rolandfiksdal/quadruped/stm32/quadruped_stm32/Core/Src/main.c

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
/* Includes ------------------------------------------------------------------*/
#include "main.h"

/* USER CODE BEGIN Includes */
#include "bmi088.h"
#include "robstride_can.h"
#include "robot_joints.h"
#include <stdio.h>

/* USER CODE END Includes */

/* USER CODE BEGIN PTD */

typedef enum
{
    POSE_DISABLED,
    POSE_STOPPING,
    POSE_TRANSITIONING,
    POSE_HOLDING
} PoseState_t;

/* Which pose is selected is separate from whether it is moving or holding. */
typedef enum
{
    TARGET_RETRACTED,
    TARGET_STANDING,
    TARGET_RETRACTED_BEFORE_REST,
    TARGET_RESTING
} PoseTarget_t;

typedef struct
{
    MotorId_t joint;
    const char *name;
    float target_rad;
} JointTarget_t;

/* USER CODE END PTD */

/* USER CODE BEGIN PD */
#define COMMAND_INTERVAL_MS 20U
#define COMMAND_BATCH_TIMEOUT_MS 50U

/* USER CODE END PD */


COM_InitTypeDef BspCOMInit;
FDCAN_HandleTypeDef hfdcan1;

SPI_HandleTypeDef hspi3;

/* USER CODE BEGIN PV */
static const JointTarget_t standing_targets[] =
    {
        {MOTOR_FL_HAA, "FL_HAA", 0.0f},
        {MOTOR_FL_HFE, "FL_HFE", -0.7f},
        {MOTOR_FL_KFE, "FL_KFE", 1.2f},
        {MOTOR_FR_HAA, "FR_HAA", 0.0f},
        {MOTOR_FR_HFE, "FR_HFE", -0.7f},
        {MOTOR_FR_KFE, "FR_KFE", 1.2f},
        {MOTOR_RL_HAA, "RL_HAA", 0.0f},
        {MOTOR_RL_HFE, "RL_HFE", -0.7f},
        {MOTOR_RL_KFE, "RL_KFE", 1.2f},
        {MOTOR_RR_HAA, "RR_HAA", 0.0f},
        {MOTOR_RR_HFE, "RR_HFE", -0.7f},
        {MOTOR_RR_KFE, "RR_KFE", 1.2f}};

static const JointTarget_t retracted_targets[] =
    {
        {MOTOR_FL_HAA, "FL_HAA", 0.0f},
        {MOTOR_FL_HFE, "FL_HFE", -0.852f},
        {MOTOR_FL_KFE, "FL_KFE", 2.34f},
        {MOTOR_FR_HAA, "FR_HAA", 0.0f},
        {MOTOR_FR_HFE, "FR_HFE", -0.853f},
        {MOTOR_FR_KFE, "FR_KFE", 2.34f},
        {MOTOR_RL_HAA, "RL_HAA", 0.0f},
        {MOTOR_RL_HFE, "RL_HFE", -0.877f},
        {MOTOR_RL_KFE, "RL_KFE", 2.34f},
        {MOTOR_RR_HAA, "RR_HAA", 0.0f},
        {MOTOR_RR_HFE, "RR_HFE", -0.857f},
        {MOTOR_RR_KFE, "RR_KFE", 2.34f}};

static const JointTarget_t resting_targets[] =
    {
        {MOTOR_FL_HAA, "FL_HAA", -0.47f},
        {MOTOR_FL_HFE, "FL_HFE", -0.852f},
        {MOTOR_FL_KFE, "FL_KFE", 2.34f},
        {MOTOR_FR_HAA, "FR_HAA", -0.47f},
        {MOTOR_FR_HFE, "FR_HFE", -0.853f},
        {MOTOR_FR_KFE, "FR_KFE", 2.34f},
        {MOTOR_RL_HAA, "RL_HAA", -0.47f},
        {MOTOR_RL_HFE, "RL_HFE", -0.877f},
        {MOTOR_RL_KFE, "RL_KFE", 2.34f},
        {MOTOR_RR_HAA, "RR_HAA", -0.47f},
        {MOTOR_RR_HFE, "RR_HFE", -0.857f},
        {MOTOR_RR_KFE, "RR_KFE", 2.34f}};

#define POSE_JOINT_COUNT (sizeof(standing_targets) / sizeof(standing_targets[0]))

_Static_assert(POSE_JOINT_COUNT == ROBSTRIDE_MOTOR_COUNT, "Pose must cover all motors");
_Static_assert(sizeof(retracted_targets) == sizeof(standing_targets), "Pose sizes must match");
_Static_assert(sizeof(resting_targets) == sizeof(standing_targets), "Pose sizes must match");

static const JointTarget_t *active_targets = retracted_targets;
static PoseTarget_t selected_pose = TARGET_RETRACTED;
static const char *active_pose_name = "retracted";

float start_positions_rad[POSE_JOINT_COUNT];
uint32_t transition_start_ms;
uint32_t last_command_ms;
uint32_t last_batch_duration_ms = 0;
uint32_t max_batch_duration_ms = 0;
uint8_t next_joint_index = 0;
uint8_t batch_in_progress = 0;
uint32_t batch_start_ms;
float batch_progress = 0.0f;
uint32_t last_batch_gap_ms = 0;
uint32_t max_batch_gap_ms = 0;
uint8_t have_previous_batch = 0;
/* Powered actuators may still be active after an MCU-only reset. */
PoseState_t pose_state = POSE_STOPPING;

volatile uint8_t acc_data_ready = 0;
volatile uint8_t gyro_data_ready = 0;
volatile uint8_t user_button_pressed = 0;
volatile uint32_t last_button_irq = 0;

volatile uint32_t acc_irq_count = 0;
volatile uint32_t gyro_irq_count = 0;
/* USER CODE END PV */

void SystemClock_Config(void);
static void MX_GPIO_Init(void);
static void MX_FDCAN1_Init(void);
static void MX_SPI3_Init(void);
/* USER CODE BEGIN 0 */
static const char *JointHealthReason(JointResult_t result)
{
    switch (result)
    {
        case JOINT_OK: return "healthy";
        case JOINT_INVALID_ID: return "invalid joint ID";
        case JOINT_OFFLINE: return "offline or state unavailable";
        case JOINT_FAULT: return "motor fault reported";
        case JOINT_NO_FEEDBACK: return "no measurement feedback received";
        case JOINT_STALE_FEEDBACK: return "measurement feedback stale";
        default: return "unexpected joint result";
    }
}

/* Supported-test policy: cancel motion and request all motors stop.
 * Disabling removes support; this is not a controlled ground-standing recovery.
 */
static void MonitorPoseHealth(void)
{
    if (pose_state != POSE_TRANSITIONING && pose_state != POSE_HOLDING)
    {
        return;
    }

    for (uint8_t i = 0; i < POSE_JOINT_COUNT; i++)
    {
        JointResult_t health = RobotJoints_CheckHealth(active_targets[i].joint);
        if (health != JOINT_OK)
        {
            batch_in_progress = 0;
            pose_state = POSE_STOPPING;
            user_button_pressed = 0;
            /* Report once: subsequent checks skip POSE_STOPPING. */
            printf("%s unhealthy: %s; requesting all motors stop\r\n",
                   active_targets[i].name, JointHealthReason(health));
            return;
        }
    }
}

/* Return true only when every stop request was queued successfully. */
static uint8_t StopAllJoints(void)
{
    uint8_t all_stopped = 1;

    for (uint8_t i = 0; i < POSE_JOINT_COUNT; i++)
    {
        JointResult_t result = RobotJoints_Stop(active_targets[i].joint);
        if (result != JOINT_OK)
        {
            printf("%s stop failed: %d\r\n", active_targets[i].name, result);
            all_stopped = 0;
        }
        HAL_Delay(2);
        RobStride_CAN_Process();
    }

    batch_in_progress = 0;
    if (all_stopped)
    {
        /* Discard presses received while stop requests were being submitted. */
        user_button_pressed = 0;
        pose_state = POSE_DISABLED;
        selected_pose = TARGET_RETRACTED;
        active_targets = retracted_targets;
        active_pose_name = "retracted";
    }

    return all_stopped;
}


/* Validate the whole destination and capture measured starts before moving. */
static void StartPoseTransition(PoseTarget_t requested_pose)
{
    if (pose_state != POSE_DISABLED && pose_state != POSE_HOLDING)
    {
        return;
    }

    const JointTarget_t *targets;
    const char *name;

    switch (requested_pose)
    {
        case TARGET_RETRACTED:
            targets = retracted_targets;
            name = "retracted";
            break;
        case TARGET_STANDING:
            targets = standing_targets;
            name = "standing";
            break;
        case TARGET_RETRACTED_BEFORE_REST:
            targets = retracted_targets;
            name = "retracted before resting";
            break;
        case TARGET_RESTING:
            targets = resting_targets;
            name = "resting";
            break;
        default:
            return;
    }

    uint8_t targets_valid = 1;
    for (uint8_t i = 0; i < POSE_JOINT_COUNT; i++)
    {
        if (RobotJoints_ValidatePosition(targets[i].joint,
                                        targets[i].target_rad) != JOINT_OK)
        {
            printf("%s rejected: %s target=%+.5f rad outside command limits\r\n",
                   name, targets[i].name, targets[i].target_rad);
            targets_valid = 0;
        }
    }
    if (!targets_valid)
    {
        return;
    }

    RobStride_CAN_Process();
    RobStride_UpdateOnlineStatus();
    uint8_t ready = 1;
    for (uint8_t i = 0; i < POSE_JOINT_COUNT; i++)
    {
        JointState_t state;
        JointResult_t health = RobotJoints_CheckHealth(targets[i].joint);
        if (health != JOINT_OK)
        {
            printf("%s not ready: %s\r\n",
                   targets[i].name, JointHealthReason(health));
            ready = 0;
        }
        else if (!RobotJoints_GetState(targets[i].joint, &state))
        {
            printf("%s not ready: state unavailable\r\n", targets[i].name);
            ready = 0;
        }
        else if (!RobotJoints_PrepareStartPosition(targets[i].joint,
                                                  state.position_rad,
                                                  &start_positions_rad[i]))
        {
            printf("%s starting position rejected: %+.5f rad\r\n",
                   targets[i].name, state.position_rad);
            ready = 0;
        }
    }
    if (!ready)
    {
        if (pose_state != POSE_DISABLED)
        {
            batch_in_progress = 0;
            pose_state = POSE_STOPPING;
        }
        return;
    }

    /* Motors stay enabled between poses; only the first press enables them. */
    if (pose_state == POSE_DISABLED)
    {
        for (uint8_t i = 0; i < POSE_JOINT_COUNT; i++)
        {
            JointResult_t result = RobotJoints_Enable(targets[i].joint);
            if (result != JOINT_OK)
            {
                printf("%s enable failed: %d\r\n", targets[i].name, result);
                batch_in_progress = 0;
                pose_state = POSE_STOPPING;
                return;
            }
            HAL_Delay(2);
            RobStride_CAN_Process();
        }
    }

    active_targets = targets;
    selected_pose = requested_pose;
    active_pose_name = name;
    next_joint_index = 0;
    batch_in_progress = 0;
    batch_progress = 0.0f;
    have_previous_batch = 0;
    last_batch_gap_ms = 0;
    max_batch_gap_ms = 0;
    last_batch_duration_ms = 0;
    max_batch_duration_ms = 0;

    printf("Moving to %s over 2 seconds\r\n", name);
    transition_start_ms = HAL_GetTick();
    last_command_ms = transition_start_ms - COMMAND_INTERVAL_MS;
    pose_state = POSE_TRANSITIONING;
}

/* USER CODE END 0 */

/**
 * @brief  The application entry point.
 * @retval int
 */
int main(void)
{

    /* MCU Configuration--------------------------------------------------------*/

    /* Reset of all peripherals, Initializes the Flash interface and the Systick. */
    HAL_Init();

    /* Configure the system clock */
    SystemClock_Config();

    /* Initialize all configured peripherals */
    MX_GPIO_Init();
    MX_FDCAN1_Init();
    MX_SPI3_Init();
    /* Initialize led */
    BSP_LED_Init(LED_GREEN);

    /* Initialize USER push-button, will be used to trigger an interrupt each time it's pressed.*/
    BSP_PB_Init(BUTTON_USER, BUTTON_MODE_EXTI);

    /* Initialize COM1 port (115200, 8 bits (7-bit data + 1 stop bit), no parity */
    BspCOMInit.BaudRate = 115200;
    BspCOMInit.WordLength = COM_WORDLENGTH_8B;
    BspCOMInit.StopBits = COM_STOPBITS_1;
    BspCOMInit.Parity = COM_PARITY_NONE;
    BspCOMInit.HwFlowCtl = COM_HWCONTROL_NONE;
    if (BSP_COM_Init(COM1, &BspCOMInit) != BSP_ERROR_NONE)
    {
        Error_Handler();
    }

    /* Infinite loop */
    /* USER CODE BEGIN WHILE */

    RobotJoints_Init();

    if (!RobStride_CAN_Init())
    {
        printf("CAN init failed; startup blocked, motor stops not confirmed\r\n");
        Error_Handler();
    }
    else
    {
        printf("CAN init success\r\n");

        /* Stop before discovery, reporting setup, or IMU initialization.
         * RobotJoints_Stop does not require a motor to be discovered/online.
         * Stay here on submission failure; pose/button handling cannot run.
         */
        while (!StopAllJoints())
        {
            user_button_pressed = 0;
        }
        printf("Startup: all 12 stop requests queued; motor disable unconfirmed\r\n");

        RobStride_RequestAllDeviceIDs();

        HAL_Delay(200);

        /*
         * responses are sitting in FIFO0,
         * so process them before inspecting states.
         */
        RobStride_CAN_Process();

        RobStride_SetAllActiveReporting(1);

        uint8_t online_count = 0;

        for (uint8_t id = 1; id <= ROBSTRIDE_MOTOR_COUNT; id++)
        {
            const RobStride_Motor_t *motor =
                RobStride_GetMotor((MotorId_t)id);

            if (motor != NULL && motor->online)
            {
                printf("Motor %2u: ONLINE\r\n", id);
                online_count++;
            }
            else
            {
                printf("Motor %2u: OFFLINE\r\n", id);
            }
        }

        printf("%u/%u motors online\r\n",
               online_count,
               ROBSTRIDE_MOTOR_COUNT);
    }

    if (!BMI088_Init())
    {
        printf("BMI088 init failed\r\n");
    }
    else
    {
        printf("BMI088 init success\r\n");
    }

    printf("Feedback timeout: %lu ms (provisional supported-test limit)\r\n",
           (unsigned long)ROBOT_FEEDBACK_TIMEOUT_MS);
    printf("Startup complete; press button to begin\r\n");
    /* Also discard presses during discovery, IMU init, and startup logging. */
    user_button_pressed = 0;

    uint32_t last_joint_print = 0;

    while (1)
    {
        RobStride_CAN_Process();

        RobStride_UpdateOnlineStatus();

        MonitorPoseHealth();

        if ((pose_state == POSE_DISABLED || pose_state == POSE_HOLDING) &&
            HAL_GetTick() - last_joint_print >= 800)
        {
            last_joint_print = HAL_GetTick();
            printf("Pose: %s, %s\r\n", active_pose_name,
                   pose_state == POSE_DISABLED ? "DISABLED (next target)" : "HOLDING");

            for (uint8_t id = 1; id <= ROBSTRIDE_MOTOR_COUNT; id++)
            {
                JointState_t state;

                if (RobotJoints_GetState((MotorId_t)id, &state))
                {
                    printf(
                        "Motor %2u: joint=%+.4f rad, torque=%+.3f Nm, temp=%.1f C, %s",
                        id,
                        state.position_rad,
                        state.torque_nm,
                        state.temperature_c,
                        state.online ? "ONLINE" : "OFFLINE");
                    if (state.feedback_received)
                    {
                        printf(", feedback age=%lu ms, gap last/max=%lu/%lu ms%s",
                               (unsigned long)state.feedback_age_ms,
                               (unsigned long)state.feedback_gap_last_ms,
                               (unsigned long)state.feedback_gap_max_ms,
                               state.feedback_age_ms >= ROBOT_FEEDBACK_TIMEOUT_MS
                                   ? " STALE" : "");
                    }
                    else
                    {
                        printf(", NO MEASUREMENT FEEDBACK");
                    }
                    for (uint8_t i = 0; i < POSE_JOINT_COUNT; i++)
                    {
                        if ((MotorId_t)id == active_targets[i].joint)
                        {
                            /* Signed remaining angle: target minus feedback. */
                            printf(
                                ", %s target=%+.4f rad, error=%+.4f rad",
                                active_targets[i].name,
                                active_targets[i].target_rad,
                                active_targets[i].target_rad - state.position_rad);
                            break;
                        }
                    }
                    printf("\r\n");
                }
                else
                {
                    printf("Motor %2u: state unavailable\r\n", id);
                }
                /* Service feedback between the blocking serial output lines. */
                RobStride_CAN_Process();
                RobStride_UpdateOnlineStatus();
                MonitorPoseHealth();
                if (pose_state == POSE_STOPPING)
                {
                    break;
                }
            }
            if (pose_state != POSE_STOPPING)
            {
                printf(
                    "Batch duration: last=%lu max=%lu ms; "
                    "start gap: last=%lu max=%lu ms\r\n",
                    (unsigned long)last_batch_duration_ms,
                    (unsigned long)max_batch_duration_ms,
                    (unsigned long)last_batch_gap_ms,
                    (unsigned long)max_batch_gap_ms
                );
            }
        }

        if (user_button_pressed)
        {
            user_button_pressed = 0;

            if (pose_state == POSE_TRANSITIONING)
            {
                printf("Still moving to %s; press again after the ramp finishes\r\n",
                       active_pose_name);
            }
            else if (pose_state == POSE_STOPPING)
            {
                /* The stop handler below retries all stop requests. */
            }
            else if (pose_state == POSE_DISABLED)
            {
                StartPoseTransition(TARGET_RETRACTED);
            }
            else if (selected_pose == TARGET_RETRACTED)
            {
                StartPoseTransition(TARGET_STANDING);
            }
            else if (selected_pose == TARGET_STANDING)
            {
                StartPoseTransition(TARGET_RETRACTED_BEFORE_REST);
            }
            else if (selected_pose == TARGET_RETRACTED_BEFORE_REST)
            {
                StartPoseTransition(TARGET_RESTING);
            }
            else
            {
                batch_in_progress = 0;
                pose_state = POSE_STOPPING;
            }
        }
        /* Starting a pose can process new feedback while enabling motors.
         * Recheck it before submitting any position command.
         */
        RobStride_CAN_Process();
        RobStride_UpdateOnlineStatus();
        MonitorPoseHealth();

        if (pose_state == POSE_TRANSITIONING)
        {
            uint32_t now = HAL_GetTick();

            /* Start a new batch only when the previous one is finished and time is due. */
            if (!batch_in_progress &&
                now - last_command_ms >= COMMAND_INTERVAL_MS)
            {
                if (have_previous_batch)
                {
                    last_batch_gap_ms = now - last_command_ms;

                    if (last_batch_gap_ms > max_batch_gap_ms)
                    {
                        max_batch_gap_ms = last_batch_gap_ms;
                    }
                }

                have_previous_batch = 1;

                next_joint_index = 0;
                batch_start_ms = now;
                last_command_ms = now;

                uint32_t elapsed_ms = now - transition_start_ms;
                batch_progress = (float)elapsed_ms / 2000.0f;

                if (batch_progress > 1.0f)
                {
                    batch_progress = 1.0f;
                }

                batch_in_progress = 1;
            }

            if (batch_in_progress &&
                now - batch_start_ms >= COMMAND_BATCH_TIMEOUT_MS)
            {
                batch_in_progress = 0;
                pose_state = POSE_STOPPING;

                printf("Batch timeout: queued %u/%u commands\r\n",
                    (unsigned int)next_joint_index,
                    (unsigned int)POSE_JOINT_COUNT);
            }

            /* Attempt at most one command per main-loop pass. */
            if (batch_in_progress && RobStride_CAN_CanSend())
            {
                uint8_t i = next_joint_index;

                float s = batch_progress;
                float smooth_progress = s * s * (3.0f - 2.0f * s);

                float target =
                    start_positions_rad[i]
                    + (active_targets[i].target_rad - start_positions_rad[i])
                    * smooth_progress;

                JointResult_t result = RobotJoints_Command(
                    active_targets[i].joint,
                    target,
                    0.0f,
                    0.0f,
                    60.0f,
                    5.0f);

                if (result != JOINT_OK)
                {
                    printf("%s command failed: %d\r\n",
                        active_targets[i].name, result);

                    batch_in_progress = 0;
                    pose_state = POSE_STOPPING;
                }
                else
                {
                    next_joint_index++;

                    if (next_joint_index == POSE_JOINT_COUNT)
                    {
                        batch_in_progress = 0;

                        last_batch_duration_ms =
                            HAL_GetTick() - batch_start_ms;

                        if (last_batch_duration_ms > max_batch_duration_ms)
                        {
                            max_batch_duration_ms = last_batch_duration_ms;
                        }

                        if (batch_progress >= 1.0f)
                        {
                            pose_state = POSE_HOLDING;
                            printf("%s ramp finished; final targets queued\r\n",
                                   active_pose_name);
                        }
                    }
                }
            }
        }

        if (pose_state == POSE_STOPPING)
        {
            if (StopAllJoints())
            {
                printf("All 12 joint stop requests queued\r\n");
            }
        }
    }
    /* USER CODE END WHILE */

}

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
/* USER CODE BEGIN 4 */

void HAL_GPIO_EXTI_Callback(uint16_t GPIO_Pin)
{
    if (GPIO_Pin == ACC_INT_Pin)
    {
        acc_data_ready = 1;
        acc_irq_count++;
    }

    if (GPIO_Pin == GYRO_INT_Pin)
    {
        gyro_data_ready = 1;
        gyro_irq_count++;
    }

    if (GPIO_Pin == B1_BUTTON_Pin)
    {
        uint32_t now = HAL_GetTick();

        if (now - last_button_irq > 50)
        {
            last_button_irq = now;
            user_button_pressed = 1;
        }
    }
}

/* USER CODE END 4 */
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
