rolandfiksdal/quadruped/stm32/quadruped_stm32/Core/Inc/main.h

#define B1_BUTTON_Pin GPIO_PIN_13
#define B1_BUTTON_GPIO_Port GPIOC
#define B1_BUTTON_EXTI_IRQn EXTI15_10_IRQn
#define RCC_OSC32_IN_Pin GPIO_PIN_14
#define RCC_OSC32_IN_GPIO_Port GPIOC
#define RCC_OSC32_OUT_Pin GPIO_PIN_15
#define RCC_OSC32_OUT_GPIO_Port GPIOC
#define RCC_OSC_IN_Pin GPIO_PIN_0
#define RCC_OSC_IN_GPIO_Port GPIOF
#define RCC_OSC_OUT_Pin GPIO_PIN_1
#define RCC_OSC_OUT_GPIO_Port GPIOF
#define ACC_INT_Pin GPIO_PIN_4
#define ACC_INT_GPIO_Port GPIOC
#define ACC_INT_EXTI_IRQn EXTI4_IRQn
#define GYRO_INT_Pin GPIO_PIN_5
#define GYRO_INT_GPIO_Port GPIOC
#define GYRO_INT_EXTI_IRQn EXTI9_5_IRQn
#define T_SWDIO_Pin GPIO_PIN_13
#define T_SWDIO_GPIO_Port GPIOA
#define T_SWCLK_Pin GPIO_PIN_14
#define T_SWCLK_GPIO_Port GPIOA
#define T_SWO_Pin GPIO_PIN_3
#define T_SWO_GPIO_Port GPIOB
#define ACC_CS_Pin GPIO_PIN_6
#define ACC_CS_GPIO_Port GPIOB
#define GYRO_CS_Pin GPIO_PIN_7
#define GYRO_CS_GPIO_Port GPIOB
