rolandfiksdal/quadruped/stm32/quadruped_stm32/Core/Src/robot_joints.c

#include "robot_joints.h"
#include <stddef.h>
#include <math.h>

/* Constants */

#define DEG_TO_RAD 0.01745329252f
#define PI_F       3.14159265f
#define TWO_PI_F   6.28318531f
#define START_POSITION_TOLERANCE_RAD 0.008f

/* Private calibration data; array index is the motor/joint ID. */

typedef struct
{
    int8_t sign;

    float motor_reference_rad;
    float joint_reference_rad;

    float min_rad;
    float max_rad;

} JointConfig_t;

/* IDs start at 1; index 0 is unused. */
static JointConfig_t joint_config[ROBSTRIDE_MOTOR_COUNT + 1];

/* Private coordinate helpers */

static uint8_t RobotJoints_IsValid(MotorId_t joint)
{
    return joint >= 1 &&
           joint <= ROBSTRIDE_MOTOR_COUNT;
}

static float RobotJoints_WrapToPi(float angle)
{
    while (angle > PI_F)
    {
        angle -= TWO_PI_F;
    }

    while (angle < -PI_F)
    {
        angle += TWO_PI_F;
    }

    return angle;
}

static float RobotJoints_JointToMotorPosition(
    MotorId_t joint,
    float joint_position_rad)
{
    const JointConfig_t *config =
        &joint_config[joint];

    const RobStride_Motor_t *motor =
        RobStride_GetMotor(joint);

    float base_target =
        config->motor_reference_rad
        + config->sign *
          (joint_position_rad -
           config->joint_reference_rad);

    if (motor == NULL)
    {
        return base_target;
    }

    /*
     * Move the target onto the 2*pi-equivalent branch
     * closest to the motor's current reported position.
     */
    while (base_target - motor->position_rad > PI_F)
    {
        base_target -= TWO_PI_F;
    }

    while (base_target - motor->position_rad < -PI_F)
    {
        base_target += TWO_PI_F;
    }

    return base_target;
}

/* Initialization / calibration */

void RobotJoints_Init(void)
{
    /*
     * FL HAA
     * Motor zero = minimum abduction position.
     * Negative motor rotation = positive joint abduction.
     */
    joint_config[MOTOR_FL_HAA] = (JointConfig_t)
    {
        .sign = -1,
        .motor_reference_rad = 0.0f,
        .joint_reference_rad = -27.5f * DEG_TO_RAD,
        .min_rad = -27.5f * DEG_TO_RAD,
        .max_rad =  27.5f * DEG_TO_RAD
    };

    /*
     * FR HAA
     * Positive motor rotation = positive joint abduction.
     */
    joint_config[MOTOR_FR_HAA] = (JointConfig_t)
    {
        .sign = +1,
        .motor_reference_rad = 0.0f,
        .joint_reference_rad = -27.5f * DEG_TO_RAD,
        .min_rad = -27.5f * DEG_TO_RAD,
        .max_rad =  27.5f * DEG_TO_RAD
    };

    /*
     * RL HAA
     */
    joint_config[MOTOR_RL_HAA] = (JointConfig_t)
    {
        .sign = +1,
        .motor_reference_rad = 0.0f,
        .joint_reference_rad = -27.5f * DEG_TO_RAD,
        .min_rad = -27.5f * DEG_TO_RAD,
        .max_rad =  27.5f * DEG_TO_RAD
    };

    /*
     * RR HAA
     */
    joint_config[MOTOR_RR_HAA] = (JointConfig_t)
    {
        .sign = -1,
        .motor_reference_rad = 0.0f,
        .joint_reference_rad = -27.5f * DEG_TO_RAD,
        .min_rad = -27.5f * DEG_TO_RAD,
        .max_rad =  27.5f * DEG_TO_RAD
    };

    joint_config[MOTOR_FL_HFE] = (JointConfig_t)
    {
        .sign = +1,
        .motor_reference_rad = 6.590f,
        .joint_reference_rad = 0.0f,
        .min_rad = -1.360f,
        .max_rad = +0.620f
    };

    joint_config[MOTOR_FR_HFE] = (JointConfig_t)
    {
        .sign = -1,
        .motor_reference_rad = 5.368f,
        .joint_reference_rad = 0.0f,
        .min_rad = -1.360f,
        .max_rad = +0.620f
    };

    joint_config[MOTOR_RL_HFE] = (JointConfig_t)
    {
        .sign = +1,
        .motor_reference_rad = 3.520f,
        .joint_reference_rad = 0.0f,
        .min_rad = -1.360f,
        .max_rad = +0.620f
    };

    joint_config[MOTOR_RR_HFE] = (JointConfig_t)
    {
        .sign = -1,
        .motor_reference_rad = 5.238f,
        .joint_reference_rad = 0.0f,
        .min_rad = -1.360f,
        .max_rad = +0.620f
    };

    joint_config[MOTOR_FL_KFE] = (JointConfig_t)
    {
        .sign = +1,

        .motor_reference_rad = -0.211053f,
        .joint_reference_rad = 134.82f * DEG_TO_RAD,

        .min_rad = 0.8379f,
        .max_rad = 2.353f
    };

    joint_config[MOTOR_FR_KFE] = (JointConfig_t)
    {
        .sign = -1,

        .motor_reference_rad = +0.204553f,
        .joint_reference_rad = 134.82f * DEG_TO_RAD,

        .min_rad = 0.8562f,
        .max_rad = 2.353f
    };

    joint_config[MOTOR_RL_KFE] = (JointConfig_t)
    {
        .sign = +1,

        .motor_reference_rad = +3.978647f,
        .joint_reference_rad = 134.82f * DEG_TO_RAD,

        .min_rad = 0.8535f,
        .max_rad = 2.353f
    };

    joint_config[MOTOR_RR_KFE] = (JointConfig_t)
    {
        .sign = -1,

        .motor_reference_rad = +5.516853f,
        .joint_reference_rad = 134.82f * DEG_TO_RAD,

        .min_rad = 0.8309f,
        .max_rad = 2.353f
    };
}

/* Joint state / target inspection */

JointResult_t RobotJoints_CheckHealth(MotorId_t joint)
{
    if (!RobotJoints_IsValid(joint))
    {
        return JOINT_INVALID_ID;
    }

    const RobStride_Motor_t *motor = RobStride_GetMotor(joint);
    if (motor == NULL || !motor->online)
    {
        return JOINT_OFFLINE;
    }

    if (motor->fault_bits != 0)
    {
        return JOINT_FAULT;
    }

    if (!motor->feedback_received)
    {
        return JOINT_NO_FEEDBACK;
    }

    /* Unsigned subtraction also handles the HAL tick counter wrapping. */
    if ((uint32_t)(HAL_GetTick() - motor->last_feedback_ms) >=
        ROBOT_FEEDBACK_TIMEOUT_MS)
    {
        return JOINT_STALE_FEEDBACK;
    }

    return JOINT_OK;
}

uint8_t RobotJoints_GetState(
    MotorId_t joint,
    JointState_t *state)
{
    if (!RobotJoints_IsValid(joint) || state == NULL)
    {
        return 0;
    }

    const RobStride_Motor_t *motor =
        RobStride_GetMotor(joint);

    if (motor == NULL)
    {
        return 0;
    }

    const JointConfig_t *config =
        &joint_config[joint];

    float motor_delta =
        RobotJoints_WrapToPi(
            motor->position_rad -
            config->motor_reference_rad
        );

    state->position_rad =
        config->sign * motor_delta
        + config->joint_reference_rad;

    state->velocity_rad_s =
        config->sign *
        motor->velocity_rad_s;

    state->torque_nm =
        config->sign *
        motor->torque_nm;

    state->temperature_c =
        motor->temperature_c;

    state->online =
        motor->online;

    state->fault_bits =
        motor->fault_bits;

    state->feedback_received = motor->feedback_received;
    state->feedback_age_ms = motor->feedback_received
        ? (uint32_t)(HAL_GetTick() - motor->last_feedback_ms) : 0;
    state->feedback_gap_last_ms = motor->feedback_gap_last_ms;
    state->feedback_gap_max_ms = motor->feedback_gap_max_ms;

    return 1;
}

float RobotJoints_GetMotorTarget(
    MotorId_t joint,
    float joint_position_rad)
{
    if (!RobotJoints_IsValid(joint))
    {
        return 0.0f;
    }

    return RobotJoints_JointToMotorPosition(
        joint,
        joint_position_rad);
}

uint8_t RobotJoints_PrepareStartPosition(
    MotorId_t joint,
    float measured_position_rad,
    float *start_position_rad)
{
    if (!RobotJoints_IsValid(joint) ||
        start_position_rad == NULL ||
        !isfinite(measured_position_rad))
    {
        return 0;
    }

    const JointConfig_t *config = &joint_config[joint];

    if (measured_position_rad < config->min_rad - START_POSITION_TOLERANCE_RAD ||
        measured_position_rad > config->max_rad + START_POSITION_TOLERANCE_RAD)
    {
        return 0;
    }

    float target = measured_position_rad;

    if (target < config->min_rad)
    {
        target = config->min_rad;
    }
    else if (target > config->max_rad)
    {
        target = config->max_rad;
    }

    *start_position_rad = target;
    return 1;
}

/* Joint control */

JointResult_t RobotJoints_ValidatePosition(MotorId_t joint, float position_rad)
{
    if (!RobotJoints_IsValid(joint))
    {
        return JOINT_INVALID_ID;
    }

    const JointConfig_t *config = &joint_config[joint];
    if (!isfinite(position_rad) || position_rad < config->min_rad ||
        position_rad > config->max_rad)
    {
        return JOINT_OUT_OF_RANGE;
    }

    return JOINT_OK;
}

JointResult_t RobotJoints_Enable(MotorId_t joint)
{
    JointResult_t health = RobotJoints_CheckHealth(joint);
    if (health != JOINT_OK)
    {
        return health;
    }

    if (RobStride_Enable(joint) != HAL_OK)
    {
        return JOINT_CAN_ERROR;
    }

    return JOINT_OK;
}

JointResult_t RobotJoints_Stop(MotorId_t joint)
{
    if (!RobotJoints_IsValid(joint))
    {
        return JOINT_INVALID_ID;
    }

    if (RobStride_Stop(joint) != HAL_OK)
    {
        return JOINT_CAN_ERROR;
    }

    return JOINT_OK;
}

JointResult_t RobotJoints_Command(
    MotorId_t joint,
    float position_rad,
    float velocity_rad_s,
    float torque_nm,
    float kp,
    float kd)
{
    JointResult_t health = RobotJoints_CheckHealth(joint);
    if (health != JOINT_OK)
    {
        return health;
    }

    const JointConfig_t *config =
        &joint_config[joint];

    /*
     * Never silently command outside the
     * calibrated mechanical range.
     */
    if (RobotJoints_ValidatePosition(joint, position_rad) != JOINT_OK)
    {
        return JOINT_OUT_OF_RANGE;
    }

    float motor_position =
        RobotJoints_JointToMotorPosition(
            joint,
            position_rad);

    /*
     * Velocity and torque directions must
     * follow the same sign convention.
     */
    float motor_velocity =
        config->sign * velocity_rad_s;

    float motor_torque =
        config->sign * torque_nm;

    if (RobStride_Command(
            joint,
            motor_position,
            motor_velocity,
            motor_torque,
            kp,
            kd) != HAL_OK)
    {
        return JOINT_CAN_ERROR;
    }

    return JOINT_OK;
}
