rolandfiksdal/quadruped/stm32/quadruped_stm32/Core/Inc/robot_joints.h

#ifndef ROBOT_JOINTS_H
#define ROBOT_JOINTS_H

#include "robstride_can.h"
#include <stdint.h>

/* Provisional supported-test limit; tune using measured feedback gaps.
 * Age >= this value is stale. This is not a validated physical stop deadline.
 */
#define ROBOT_FEEDBACK_TIMEOUT_MS 500U

typedef struct
{
    float position_rad;
    float velocity_rad_s;
    float torque_nm;

    float temperature_c;

    uint8_t online;
    uint8_t fault_bits;

    uint8_t feedback_received;
    uint32_t feedback_age_ms; /* Meaningful only when feedback_received is set. */
    uint32_t feedback_gap_last_ms;
    uint32_t feedback_gap_max_ms;

} JointState_t;

typedef enum
{
    JOINT_OK = 0,
    JOINT_INVALID_ID,
    JOINT_OFFLINE,
    JOINT_FAULT,
    JOINT_OUT_OF_RANGE,
    JOINT_CAN_ERROR,
    JOINT_NO_FEEDBACK,
    JOINT_STALE_FEEDBACK

} JointResult_t;

/* Initialization / calibration */

/* Load calibration before reading or commanding joints. */
void RobotJoints_Init(void);

/* Joint state / target inspection */

/* Cached health only: call CAN_Process and UpdateOnlineStatus first.
 * Requires measurement feedback younger than ROBOT_FEEDBACK_TIMEOUT_MS.
 * Returns OK, INVALID_ID, OFFLINE (also unavailable state), FAULT,
 * NO_FEEDBACK, or STALE_FEEDBACK. Does not send commands.
 */
JointResult_t RobotJoints_CheckHealth(MotorId_t joint);

/* Returns 1 when state was copied, even if offline; returns 0 on invalid input. */
uint8_t RobotJoints_GetState(
    MotorId_t joint,
    JointState_t *state);

/* Conversion only: no online/fault/limit checks. Invalid ID returns 0 rad. */
float RobotJoints_GetMotorTarget(
    MotorId_t joint,
    float joint_position_rad
);

/* Returns 1 with an accepted starting target, or 0 on invalid input/range. */
uint8_t RobotJoints_PrepareStartPosition(
    MotorId_t joint,
    float measured_position_rad,
    float *start_position_rad);

/* Joint control */

/* Check a finite position against command limits without sending anything. */
JointResult_t RobotJoints_ValidatePosition(MotorId_t joint, float position_rad);

/* JOINT_OK means the CAN request was queued, not acknowledged by the motor. */
JointResult_t RobotJoints_Enable(MotorId_t joint);

/* Attempts a stop even when the motor is offline or faulted. */
JointResult_t RobotJoints_Stop(MotorId_t joint);

JointResult_t RobotJoints_Command(
    MotorId_t joint,
    float position_rad,
    float velocity_rad_s,
    float torque_nm,
    float kp,
    float kd
);

#endif /* ROBOT_JOINTS_H */
