rolandfiksdal/quadruped/(commit log)

2026-09-02 Add initial STM32 firmware with BMI088 driver
2026-09-16 Add RobStride CAN and joint control with all-leg standing pose test
    Add motor discovery, commands, feedback decoding, and online tracking. Add joint calibration, coordinate conversion, and position limits. Add a button-controlled standing pose for all 12 joints with periodic feedback and target errors. Organize drivers and fix motor ID validation.
    [main.c, main.h, quadruped_stm32.ioc, robot_joints.c, robot_joints.h, robstride_can.c, robstride_can.h]
2026-09-28 Add motor-health monitoring, startup stopping, and updated knee calibration
2026-09-28 Add 3D leg kinematics, gait visualization, and geometry tests
2026-09-29 Add offline motor feedback tests
